boztalay/OZ-1/README.md

OZ-1
====

The very first processor I designed, a small RISC processor with very limited capabilities
