boztalay/OZ-1/Diagrams/ALU Diagram.bmp

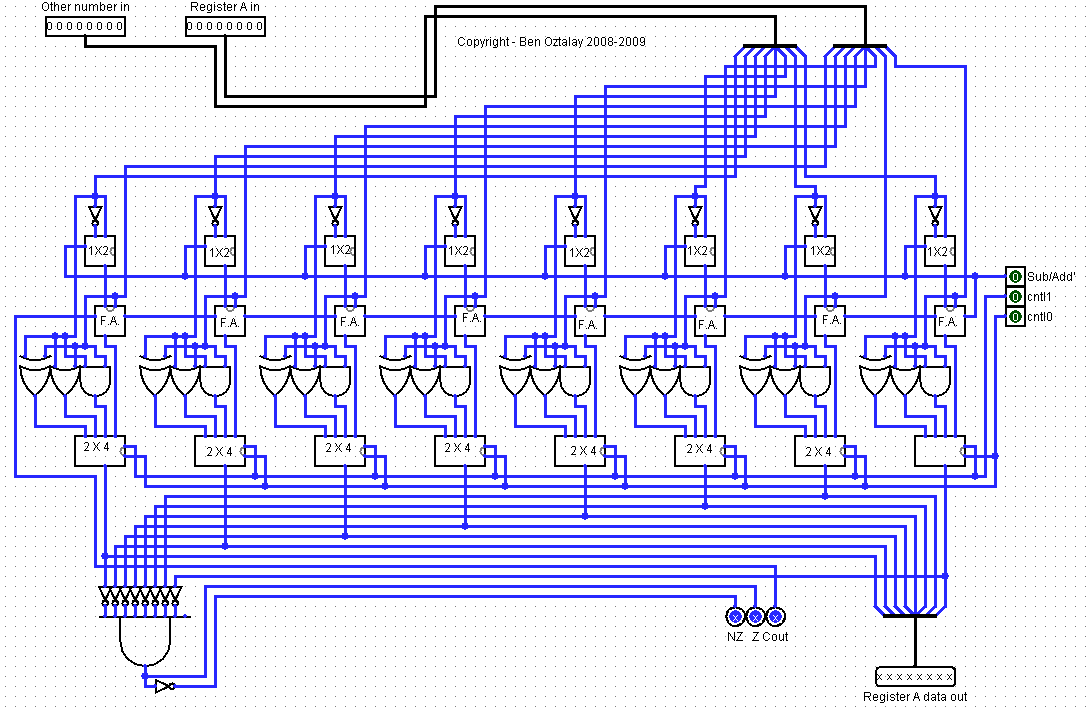
Diagrams/ALU Diagram.bmp
