boztalay/OZ-1/Diagrams/Block Diagram.bmp

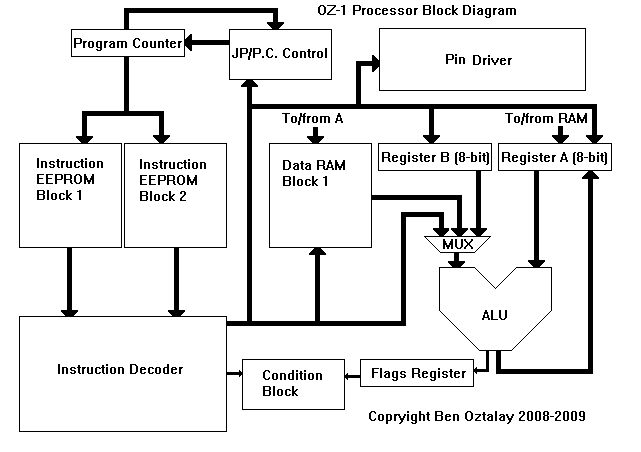
Diagrams/Block Diagram.bmp
