boztalay/OZ-1/Diagrams/Condition Block Diagram.bmp

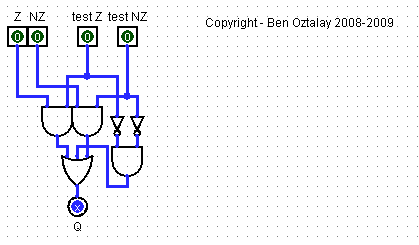
Diagrams/Condition Block Diagram.bmp
