boztalay/OZ-1/Diagrams/ISA Diagram.bmp

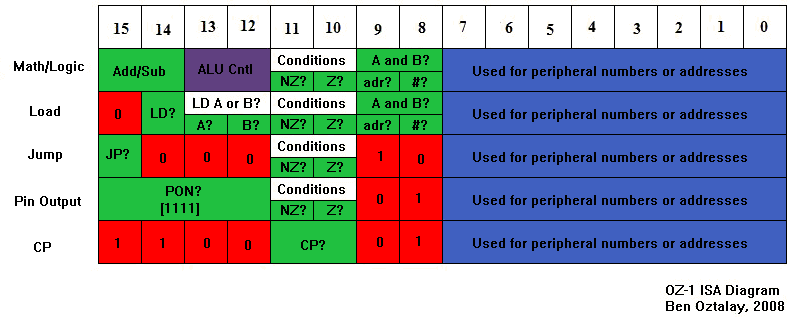
Diagrams/ISA Diagram.bmp
