boztalay/OZ-1/Diagrams/Jump PC Control Diagram.bmp

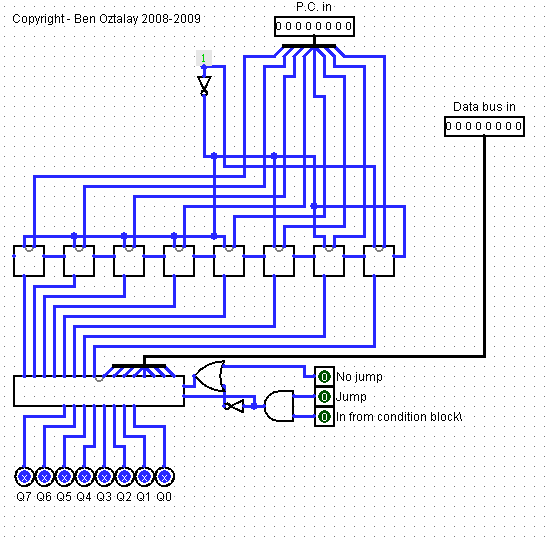
Diagrams/Jump PC Control Diagram.bmp
