boztalay/OZ-1/Diagrams/Main Diagram.bmp

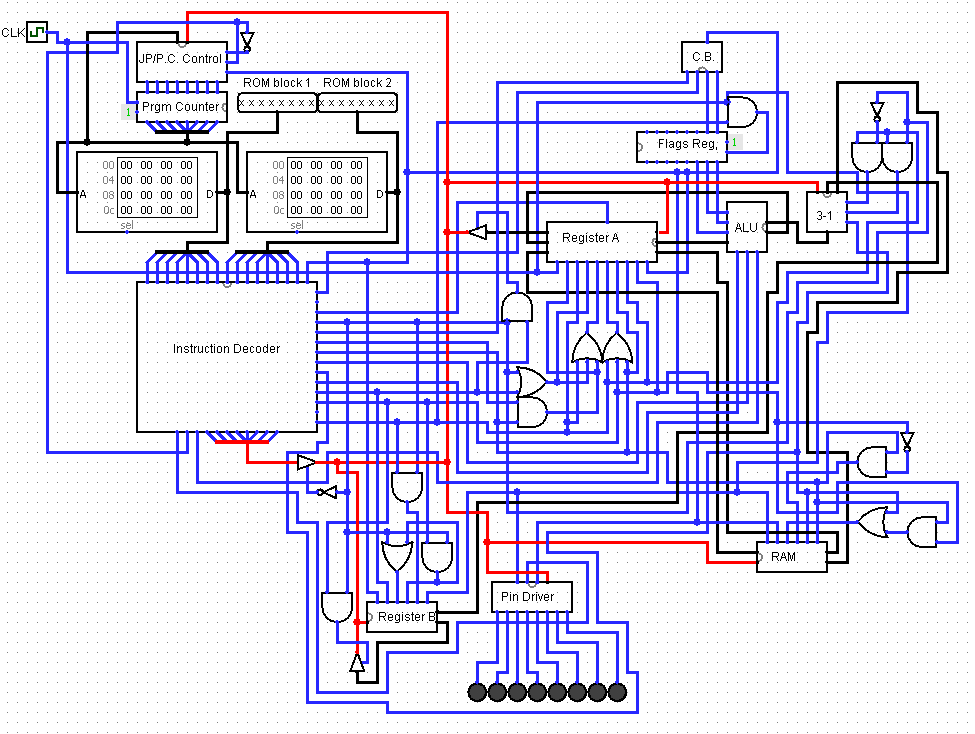
Diagrams/Main Diagram.bmp
