boztalay/OZ-1/Diagrams/Pin Driver Diagram.bmp

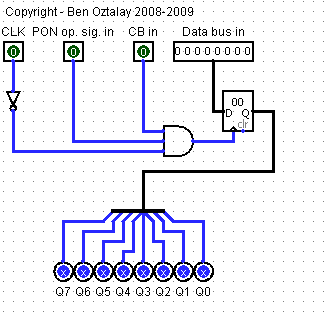
Diagrams/Pin Driver Diagram.bmp
