boztalay/OZ-1/Diagrams/RAM Diagram.bmp

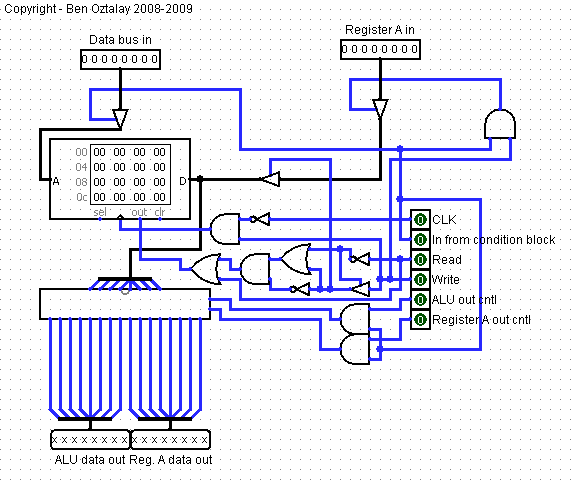
Diagrams/RAM Diagram.bmp
