boztalay/OZ-1/Diagrams/Register A Diagram.bmp

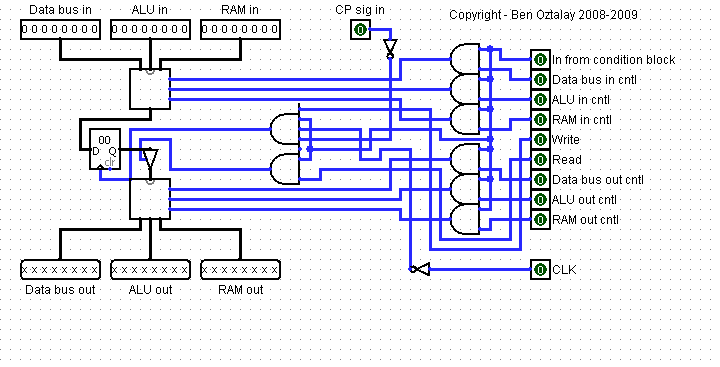
Diagrams/Register A Diagram.bmp
