boztalay/OZ-1/Diagrams/Register B Diagram.bmp

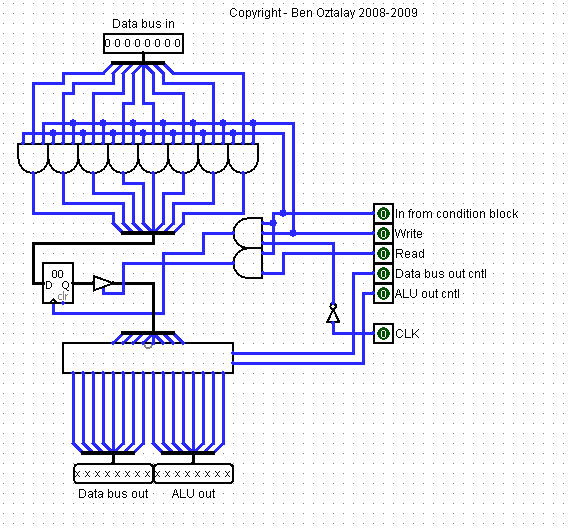
Diagrams/Register B Diagram.bmp
