boztalay/OZ-1/(list of files, drawings)

Other design files:
Logisim Diagrams/Logic Components.circ
Logisim Diagrams/OZ-1.circ
