boztalay/OZ-1/Diagrams/Instruction Decoder Diagram.bmp

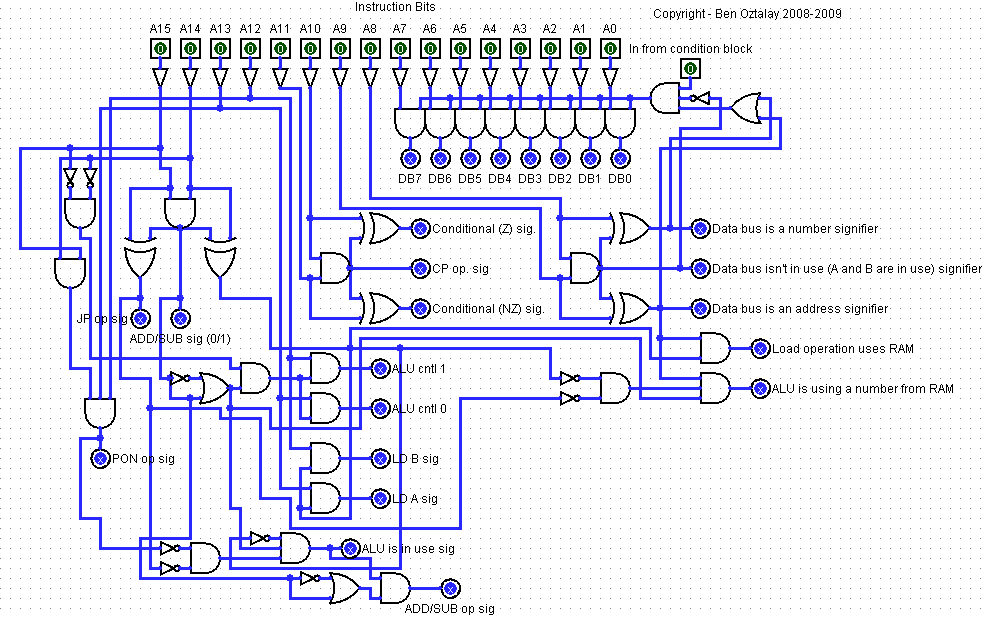
Diagrams/Instruction Decoder Diagram.bmp
